CopperPilot/CopperPilotDronePCB/review/renders/lioncircuits_dfm/pcb_u9_fpaste_comparison.png

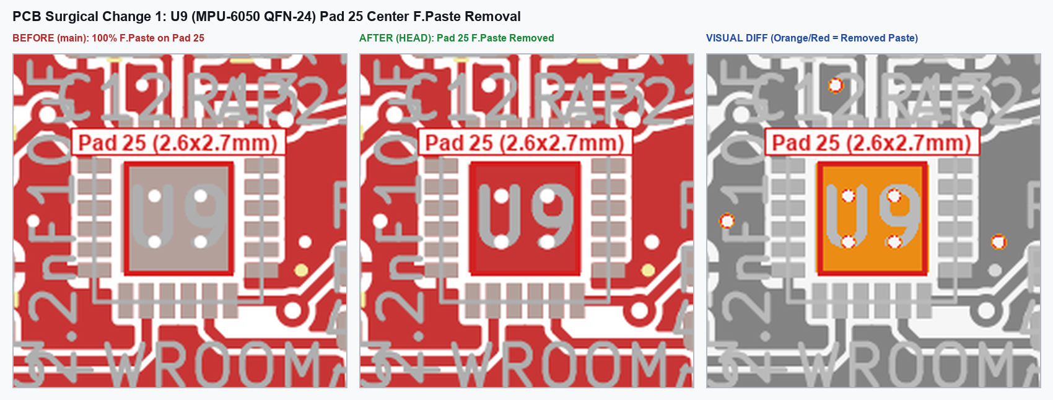
review/renders/lioncircuits_dfm/pcb_u9_fpaste_comparison.png
