CopperPilot/CopperPilotDronePCB/review/final/drc_report.txt

** Drc report for CopperPilotDrone.kicad_pcb **
** Created on 2026-10-17T00:27:32 **
** Report includes: Errors, Warnings, Exclusions **

** Found 0 DRC violations **

** Found 0 unconnected pads **

** Found 60 Footprint errors **
[footprint_symbol_field_mismatch]: Missing symbol field 'MPN' in footprint
    Local override; warning
    @(135.9040 mm, 78.5520 mm): Footprint C1
[footprint_symbol_field_mismatch]: Missing symbol field 'MPN' in footprint
    Local override; warning
    @(142.6654 mm, 79.5642 mm): Footprint C3
[footprint_symbol_field_mismatch]: Missing symbol field 'MPN' in footprint
    Local override; warning
    @(142.4597 mm, 77.8002 mm): Footprint C4
[footprint_symbol_field_mismatch]: Missing symbol field 'MPN' in footprint
    Local override; warning
    @(145.5369 mm, 76.6331 mm): Footprint C5
[footprint_symbol_field_mismatch]: Missing symbol field 'MPN' in footprint
    Local override; warning
    @(125.9091 mm, 75.4278 mm): Footprint C6
[footprint_symbol_field_mismatch]: Missing symbol field 'MPN' in footprint
    Local override; warning
    @(124.3762 mm, 75.4355 mm): Footprint C7
[footprint_symbol_field_mismatch]: Missing symbol field 'MPN' in footprint
    Local override; warning
    @(144.8905 mm, 107.3125 mm): Footprint C9
[footprint_symbol_field_mismatch]: Missing symbol field 'MPN' in footprint
    Local override; warning
    @(142.5616 mm, 107.7798 mm): Footprint C10
[footprint_symbol_field_mismatch]: Missing symbol field 'MPN' in footprint
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
    Local override; warning
    @(121.1491 mm, 66.1481 mm): Footprint SW1
[footprint_symbol_field_mismatch]: Missing symbol field 'MPN' in footprint
    Local override; warning
    @(114.0000 mm, 82.7000 mm): Footprint SW2
[footprint_symbol_field_mismatch]: Missing symbol field 'MPN' in footprint
    Local override; warning
    @(114.0000 mm, 88.5000 mm): Footprint SW3
[footprint_symbol_field_mismatch]: Missing symbol field 'MPN' in footprint
    Local override; warning
    @(145.2245 mm, 73.8607 mm): Footprint U2

** Ignored checks **
    - Footprint has no courtyard defined
    - Track endpoint not centered on via
    - Tuning profile track geometries
    - Footprint doesn't match symbol's footprint filters
    - Footprint component type doesn't match footprint pads
    - Footprint doesn't match copy in library

** End of Report **
