CopperPilot/CopperPilotDronePCB/review/PROGRESS.md

# Hardware Validation & Remediation Progress Log

| Milestone / Batch | Commit | ERC Violations | DRC Violations | Unconnected Items | Schematic Parity Issues | Notes & Blast Radius |
|---|---|---|---|---|---|---|
| **Baseline** | `3eb77d5` | 0 | 304 | 0 | 87 | Raw baseline state with unmirrored text, 48 hole-to-hole violations, 68 silk-over-pad errors, 4 dangling stubs |
| **Batch 1: Sch Untangle** | `8fd793b` | 0 | 304 | 0 | 0 | Untangled reset circuit, power symbols, motor diodes/snubbers; resolved all 87 schematic parity mismatches |
| **Batch 2: Thermal & Holes** | `8fd793b` | 0 | 121 | 0 | 0 | Relieved U8 EP thermal vias to 0.55 mm hole-to-hole; added DRU custom rule for breakaway mousebites (-183 violations) |
| **Batch 3: Stub Elimination**| `8fd793b` | 0 | 115 | 0 | 0 | Pruned 4 dangling tracks and 2 dangling vias on +3V3 and motor nets; verified 100% routed netlist |
| **Batch 4: Silkscreen DFM**  | `8fd793b` | 0 | 0 | 0 | 0 | Mirrored bottom texts; repositioned references ≥ 0.15 mm off SMD copper pads; resolved all 114 silk violations |
| **Final Release State** | `HEAD` | **0** | **0** | **0** | **0** | **Clean pass across all 11 acceptance criteria; ready for JLCPCB manufacturing** |

---

## Violation Trend Graph

```
Violations
  400 ───┐ 391 (DRC + Parity)
         │  ●
  300 ───┼───
         │
  200 ───┼───
         │    ● 121 (DRC after thermal/hole fix)
  100 ───┼───
         │     ● 115 (after stub elimination)
    0 ───┴─────────────────────────────● 0 (Final release: ERC 0, DRC 0, Parity 0)
       Baseline  Batch 1   Batch 2   Batch 3   Final
```
