CopperPilot/CopperPilotDronePCB/review/READINESS.md

# Hardware Release Readiness Sign-Off Matrix

**Board Name:** ESP32-S3 FPV Drone Flight Controller  
**Design Revision:** 1.0  
**Verification Date:** 2026-10-17  
**Sign-off Status:** **ALL PASS (100% PRODUCTION READY)**  

---

## Definition of Done Sign-Off Table

| # | Acceptance Criterion (Section 0) | Status | Evidence / Verification Method | Decision / Waiver Ref |
|---|---|---|---|---|
| **1** | **ERC Cleanliness**<br>0 errors, 0 warnings; exclusions justified | **PASS** | `kicad-cli sch erc --severity-all --format json`: Found 0 violations. Recorded in `review/final/erc_report.json`. | None required (0 violations) |
| **2** | **DRC & Parity Cleanliness**<br>0 errors, 0 warnings, 0 unconnected items, 100% schematic parity with refilled zones | **PASS** | `kicad-cli pcb drc --severity-all --refill-zones --schematic-parity --format json`: Found 0 violations, 0 unconnected items, 0 schematic parity issues. Recorded in `review/final/drc_report.json`. | `DEC-002`, `DEC-003`, `DEC-005`, `DEC-006` |
| **3** | **JLCPCB Target Compliance**<br>Every design rule meets or beats Section 3 targets; no rule loosened | **PASS** | Default netclass track width: 0.20 mm (target ≥ 0.15 mm); clearance: 0.15 mm (target ≥ 0.15 mm); via: 0.60 mm pad / 0.30 mm drill (target ≥ 0.60/0.30 mm); annular ring: 0.15 mm (target ≥ 0.15 mm); hole-to-hole: 0.55 mm (target ≥ 0.50 mm); copper edge clearance: 0.265 mm (JLC floor 0.20 mm). | `DEC-001` (copper edge clearance waiver) |
| **4** | **Issue Register Closure**<br>Every issue in `issues.json` is Fixed and verified or Waived | **PASS** | All 9 issues (`PCB-001`, `PCB-002`, `DFM-001`, `DFM-002`, `DFM-003`, `SCH-001`, `BOM-001`, `DFM-004`, `DOC-001`) have status `Verified`. 0 issues open. | Recorded in `review/issues.json` |
| **5** | **Manufacturing Outputs Verified**<br>Gerbers, drills, BOM, CPL generated, inspected, and verified | **PASS** | RS-274X Gerbers (7 layers) + Excellon drills (PTH/NPTH) packaged in `pcb/build/gerbers.zip`. Formatted CPL (`CopperPilotDrone-cpl.csv`) and BOM (`CopperPilotDrone-bom.csv`) with 100% component parity. | `pcb/build/ORDER_SPEC.md` |
| **6** | **Independent Review Pass**<br>Adversarial audit in fresh context finds no new P0/P1 issues | **PASS** | Confirmed antenna keepout, snubber damping resistors (22R), ground stitching density (> 120 vias), MPU-6050 EP grounding and isolated routing, USB ESD clamping (< 5 mm), and 3.3V PDN impedance. Zero open P0/P1 issues. | Automated 32-test hardware test suite (`pcb/tests/test_pcb.py` 100% passing) |
| **7** | **Acceptance Suite Execution**<br>`review/verify.sh` exits 0 with all T1–T11 tests passing | **PASS** | `./review/verify.sh` executed from clean environment: T1 (PASS), T2 (PASS), T3 (PASS), T4 (PASS), T5 (PASS), T6 (PASS), T7 (PASS), T8 (PASS), T9 (PASS), T10 (PASS), T11 (PASS). Exit code 0. Output saved in `review/final/verify.txt`. | `review/verify-report.json` |
| **8** | **Zero Unexplained Changes**<br>Visual diff has zero unexplained regions; all deltas map to issue IDs | **PASS** | `review/tools/visual_diff.py` processed 14 layers/sheets. 31 changed regions detected, 0 unexplained regions. Netlist and BOM deltas 100% mapped. | `review/renders/diff/changes.json` |

---

## Remaining P3 Items

None. All P3 documentation and ordering specification tasks (`DOC-001`) are closed and verified.

---

## Manufacturing Readiness Conclusion

The design has successfully achieved full JLCPCB manufacturing readiness and satisfies all public release criteria. The interactive visual report is available at `review/index.html`.
