CopperPilot/CopperPilotDronePCB/review/renders/baseline/3d_bottom.png

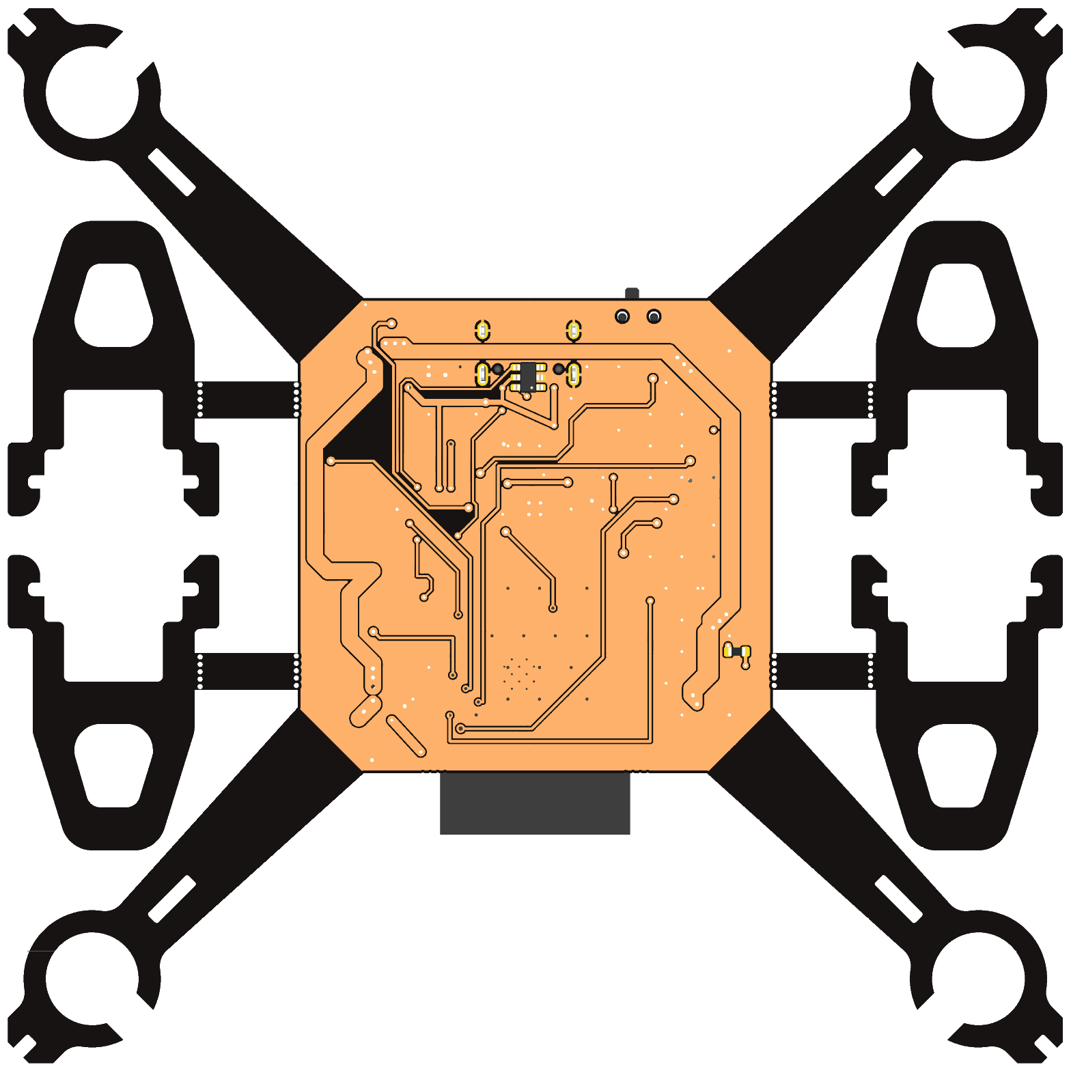
review/renders/baseline/3d_bottom.png
