CopperPilot/CopperPilotDronePCB/review/renders/baseline/3d_isometric.png

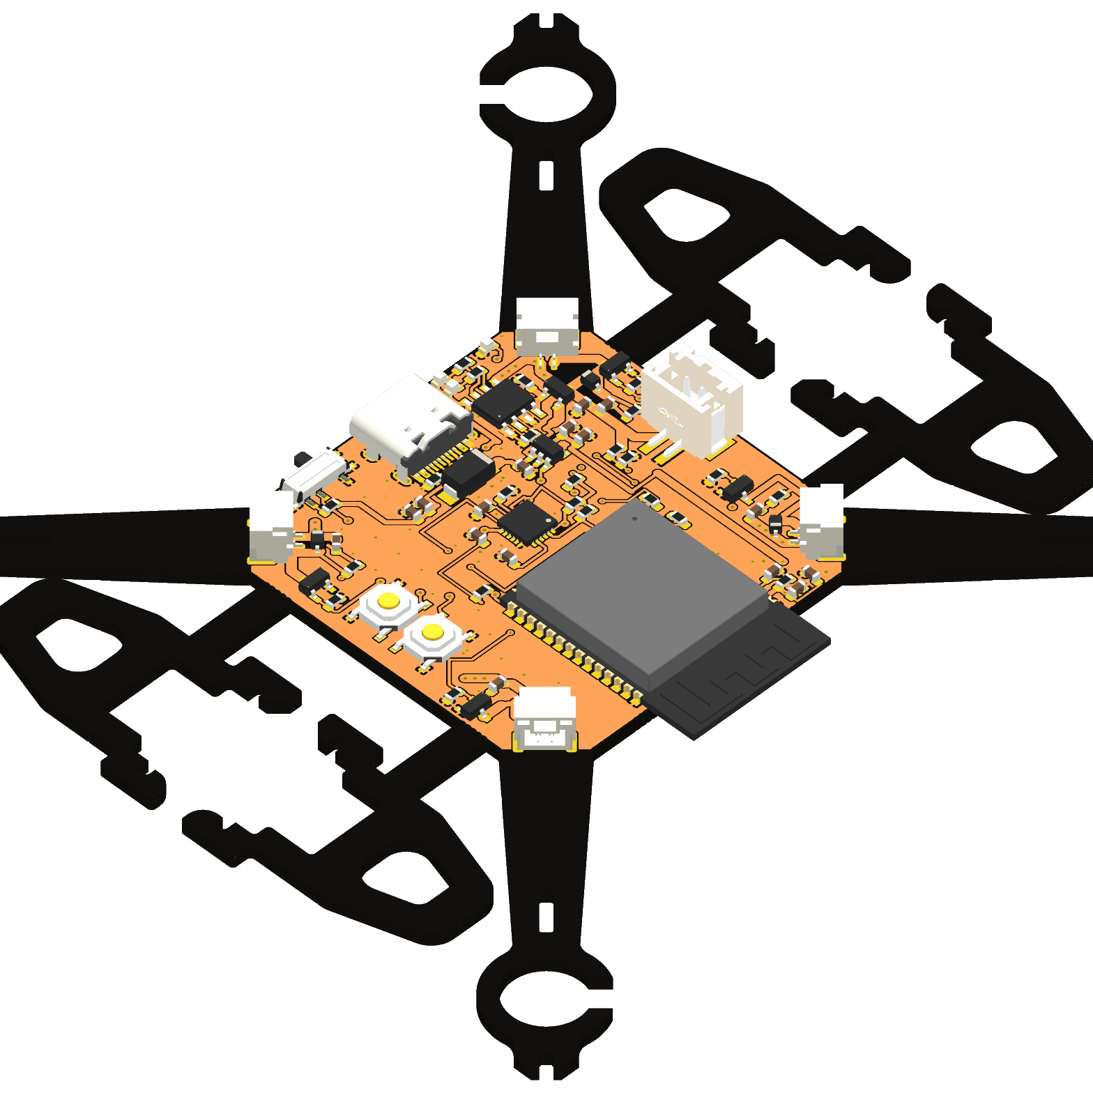
review/renders/baseline/3d_isometric.png
