CopperPilot/CopperPilotDronePCB/review/renders/baseline/B.Cu.png

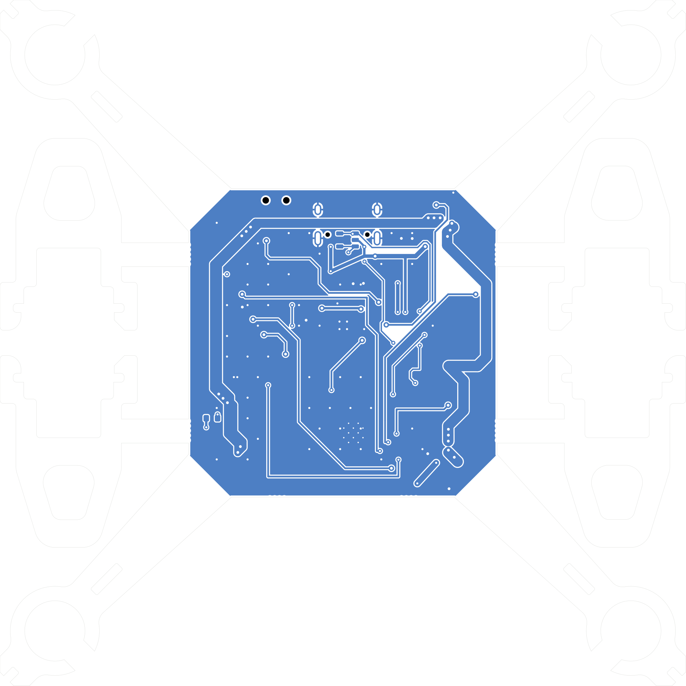
review/renders/baseline/B.Cu.png
