CopperPilot/CopperPilotDronePCB/review/renders/baseline/F.Paste.png

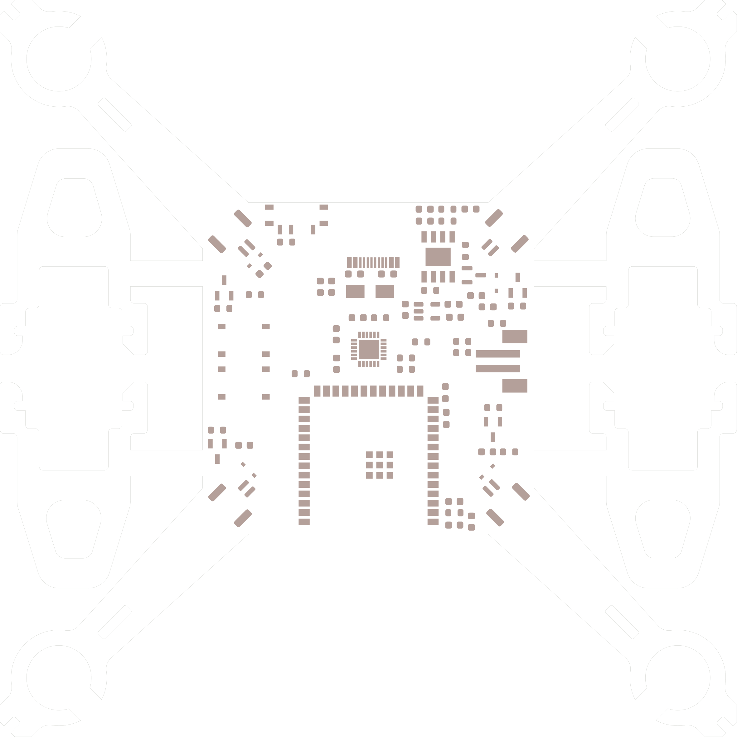
review/renders/baseline/F.Paste.png
