CopperPilot/CopperPilotDronePCB/review/renders/baseline/F.SilkS.png

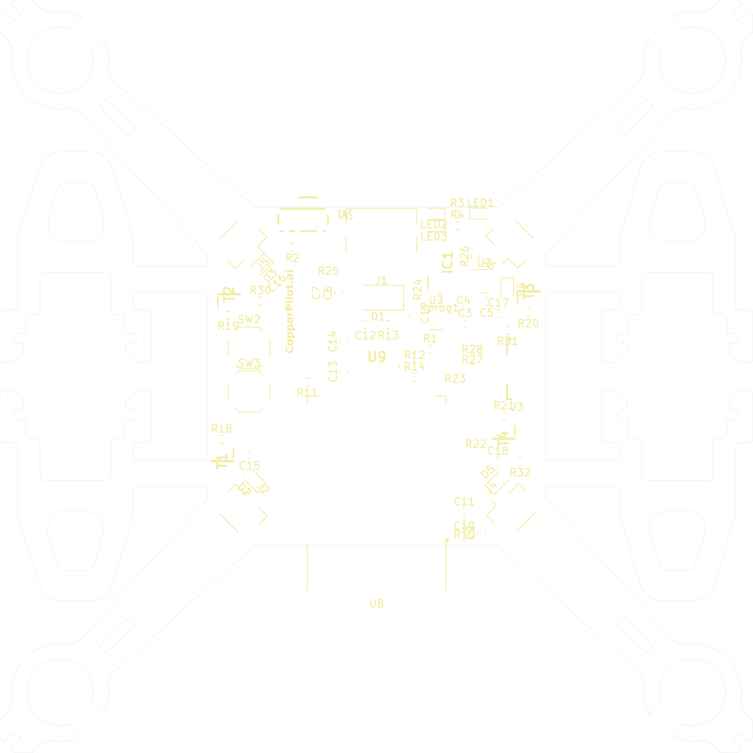
review/renders/baseline/F.SilkS.png
