CopperPilot/CopperPilotDronePCB/review/renders/diff/B.Fab.png

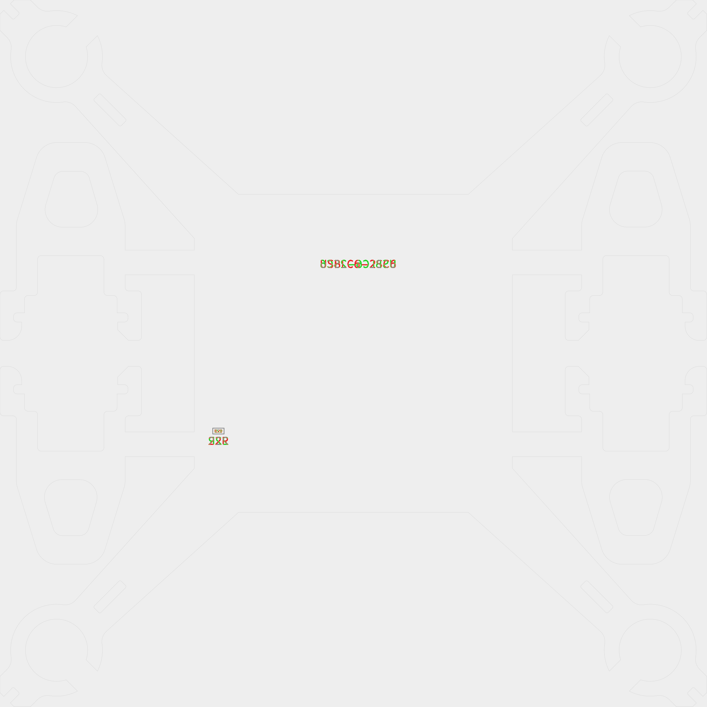
review/renders/diff/B.Fab.png
