CopperPilot/CopperPilotDronePCB/review/renders/diff/B.Mask.png

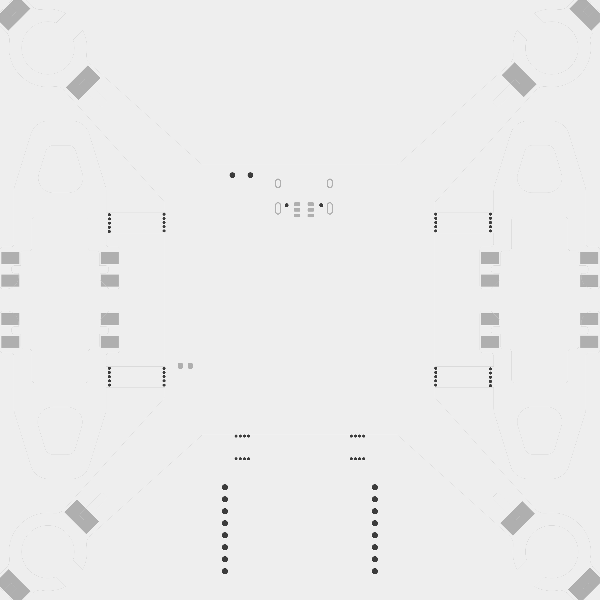
review/renders/diff/B.Mask.png
