CopperPilot/CopperPilotDronePCB/review/renders/diff/F.Cu.png

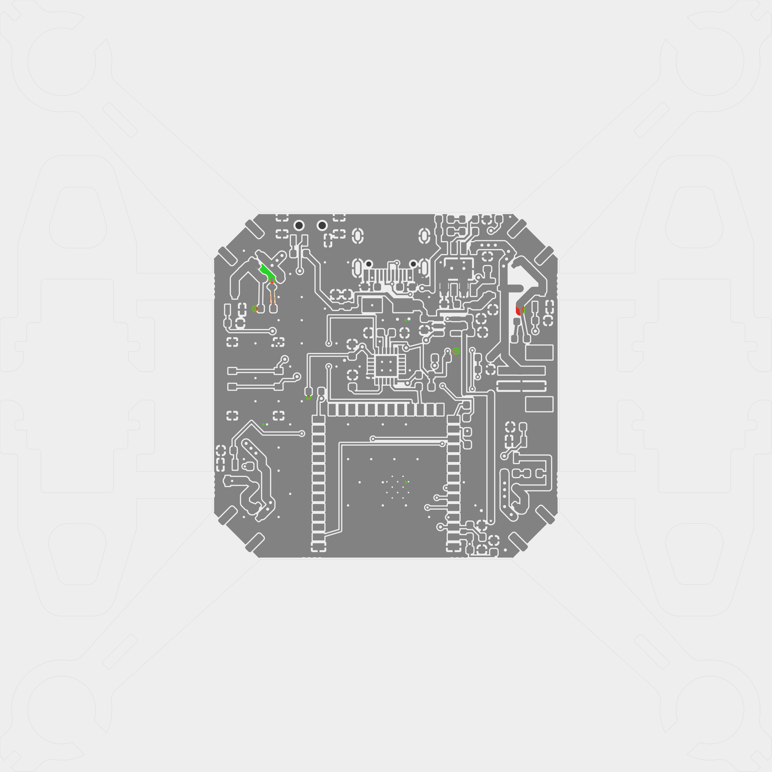
review/renders/diff/F.Cu.png
