CopperPilot/CopperPilotDronePCB/review/renders/diff/F.Fab.png

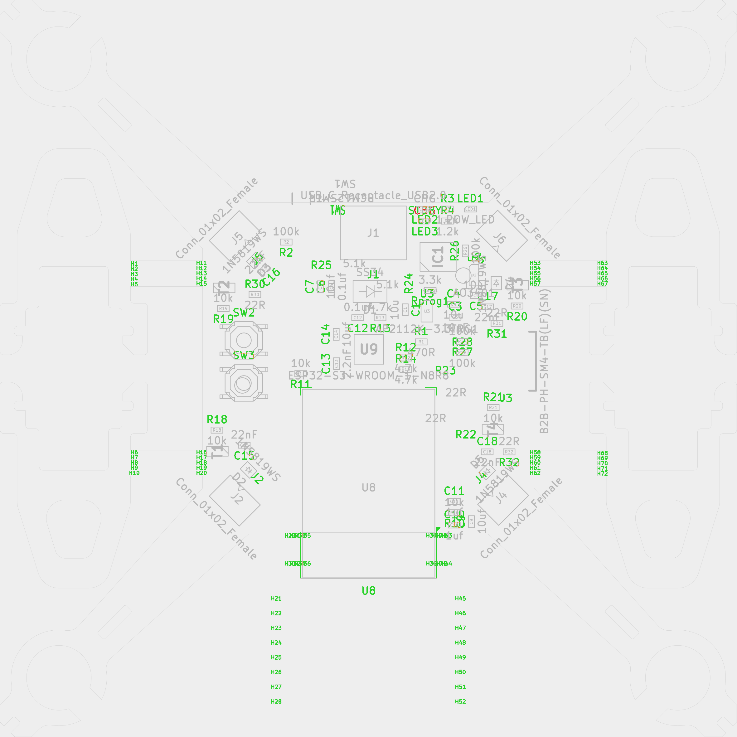
review/renders/diff/F.Fab.png
