CopperPilot/CopperPilotDronePCB/review/renders/final/3d_top.png

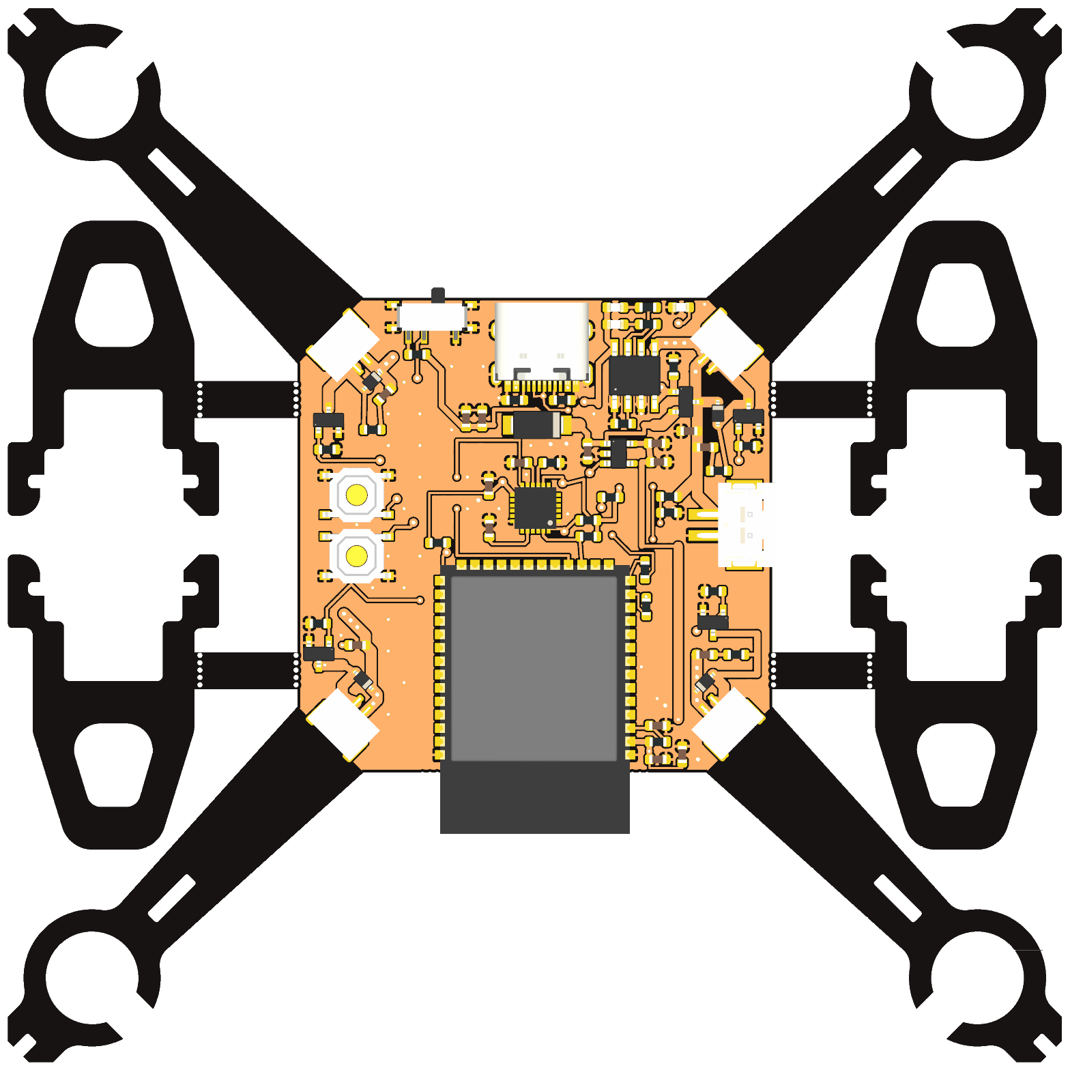
review/renders/final/3d_top.png
