CopperPilot/CopperPilotDronePCB/review/renders/final/F.Mask.png

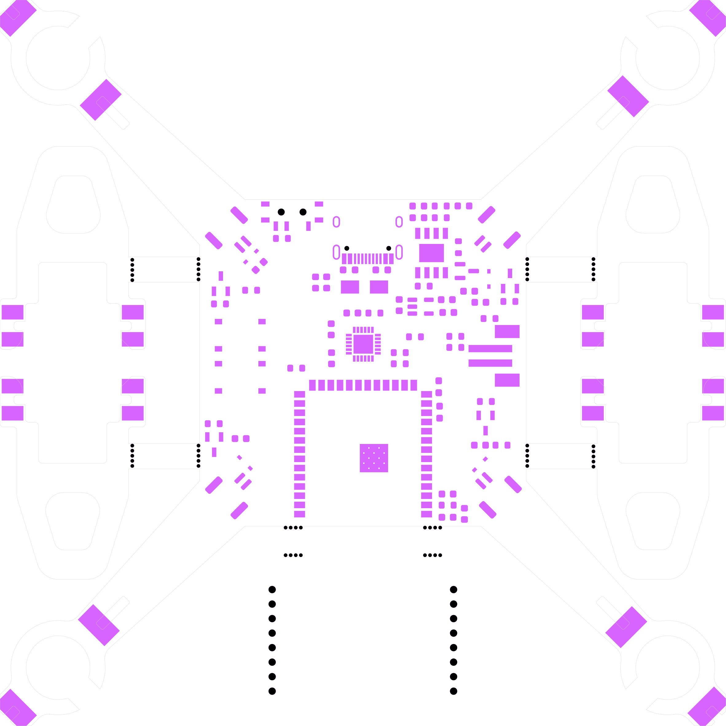
review/renders/final/F.Mask.png
