CopperPilot/CopperPilotDronePCB/review/renders/final/F.SilkS.png

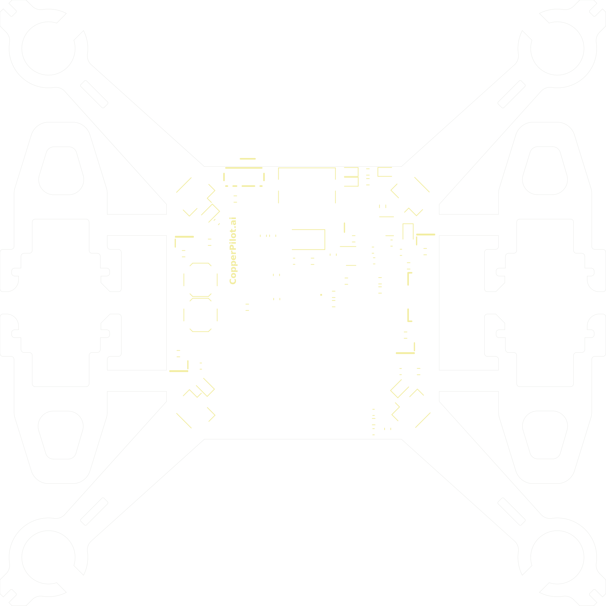
review/renders/final/F.SilkS.png
