CopperPilot/CopperPilotDronePCB/review/renders/final/schematic.png

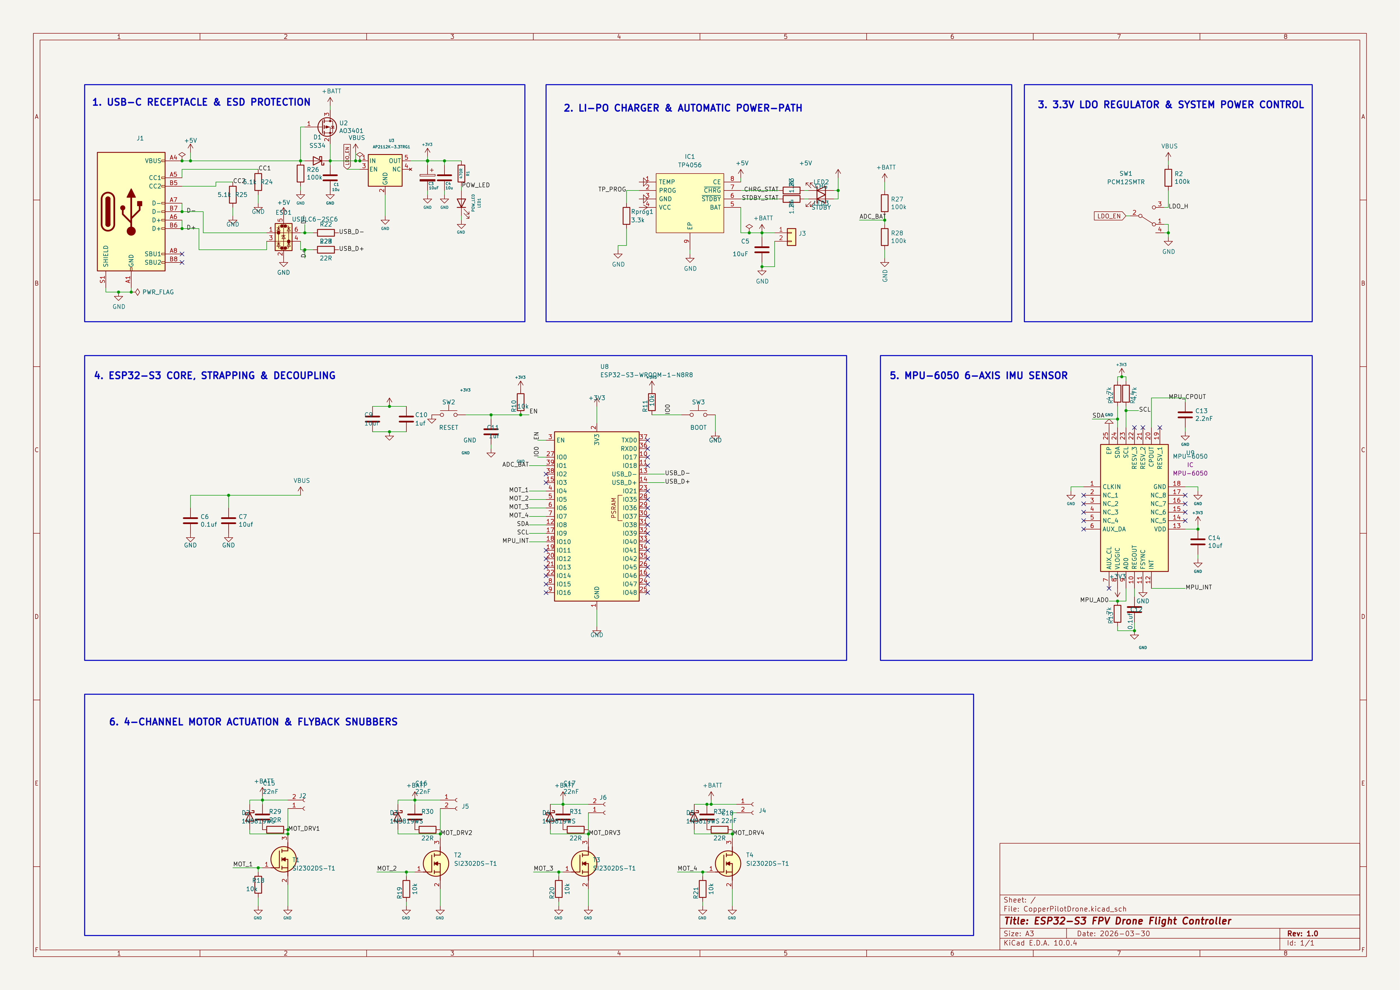
review/renders/final/schematic.png
