CopperPilot/CopperPilotDronePCB/review/renders/lioncircuits_dfm/pcb_via_upsize_bcu_comparison.png

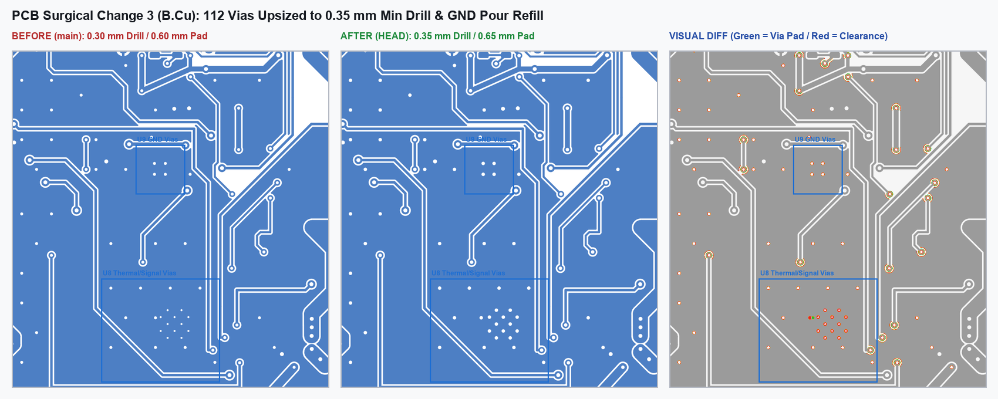
review/renders/lioncircuits_dfm/pcb_via_upsize_bcu_comparison.png
