CopperPilot/CopperPilotDronePCB/review/renders/issues/DFM-001/after.png

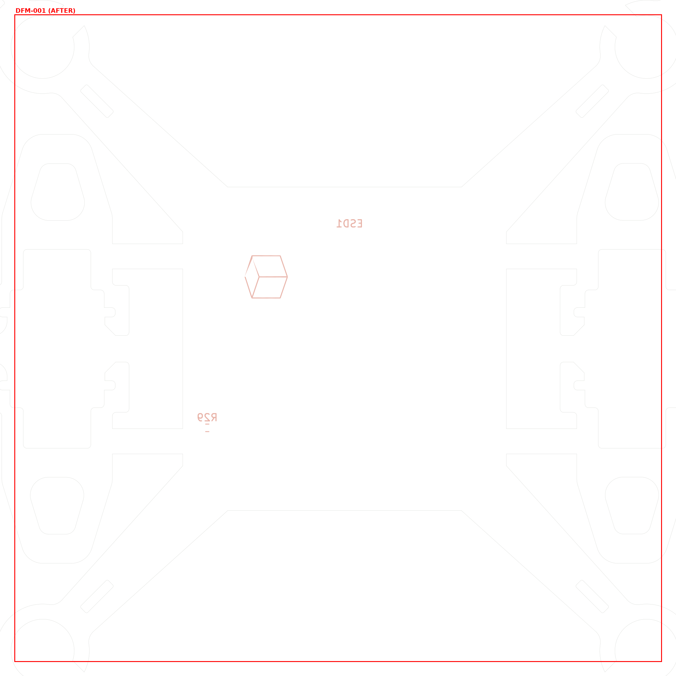
review/renders/issues/DFM-001/after.png
