CopperPilot/CopperPilotDronePCB/review/renders/issues/DFM-002/before.png

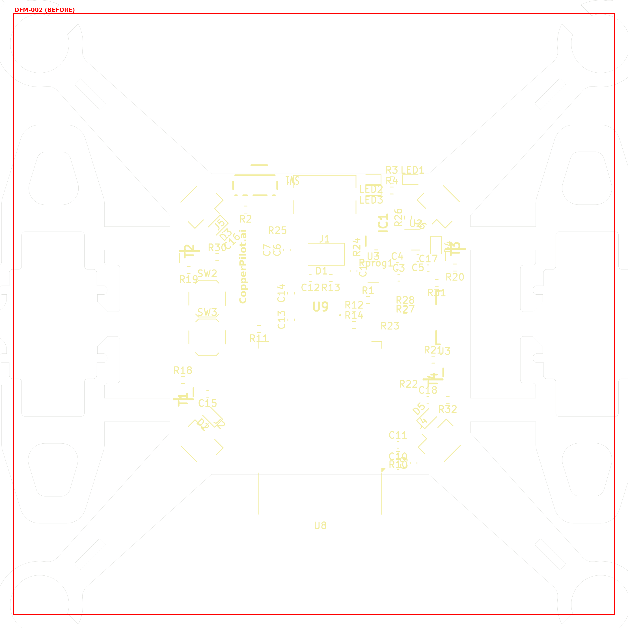
review/renders/issues/DFM-002/before.png
