CopperPilot/CopperPilotDronePCB/review/renders/issues/DFM-002/diff.png

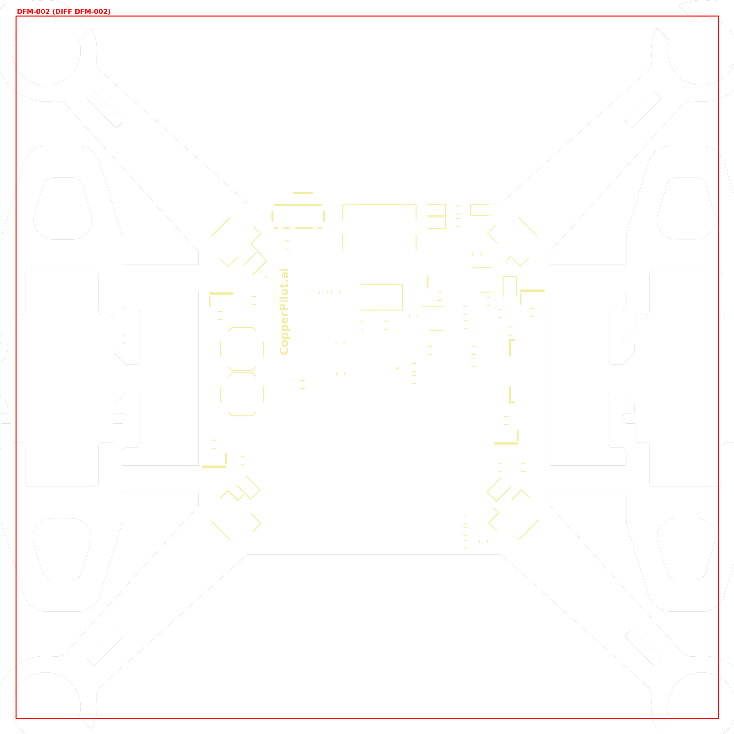
review/renders/issues/DFM-002/diff.png
