CopperPilot/CopperPilotDronePCB/review/renders/issues/DOC-001/after.png

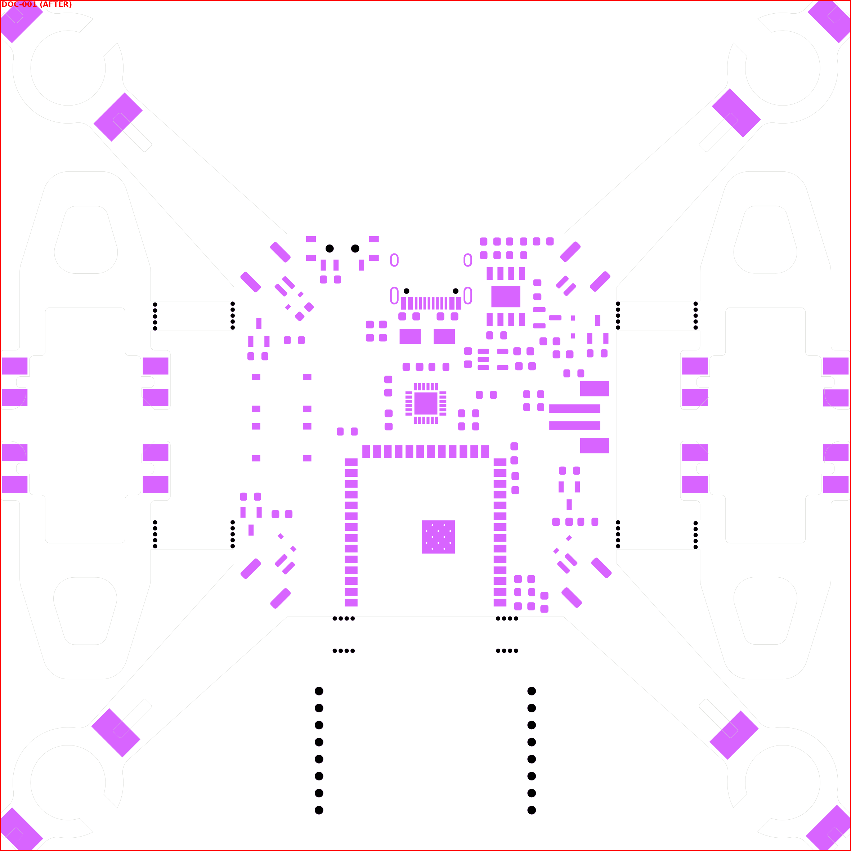
review/renders/issues/DOC-001/after.png
