CopperPilot/CopperPilotDronePCB/review/renders/issues/PCB-001/before.png

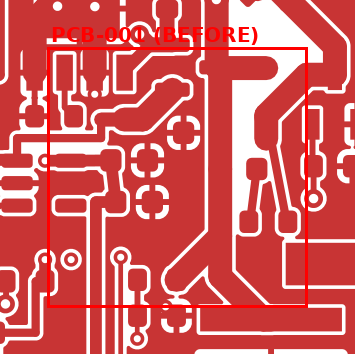
review/renders/issues/PCB-001/before.png
