CopperPilot/CopperPilotDronePCB/review/renders/issues/PCB-002/after.png

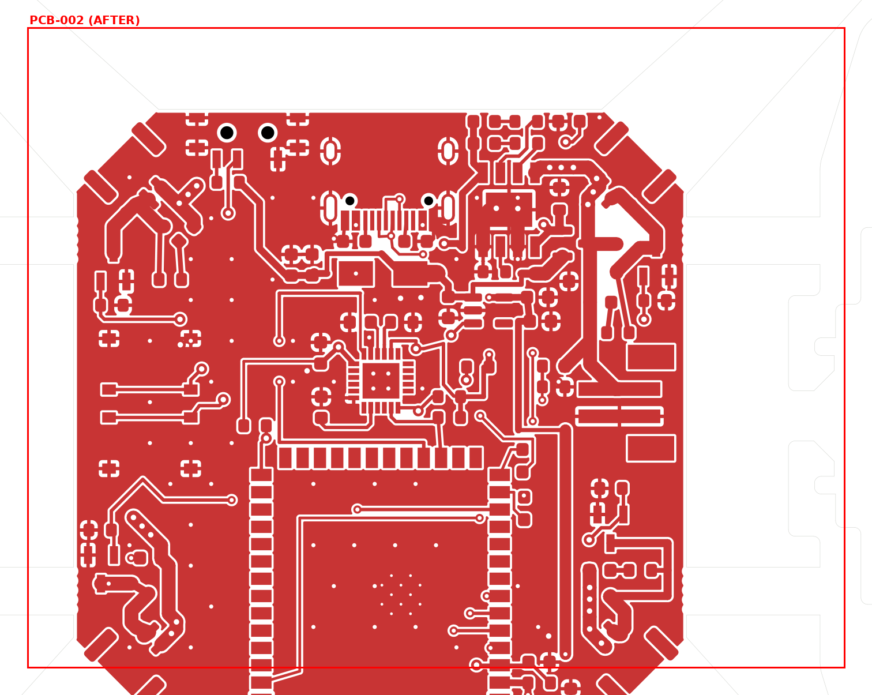
review/renders/issues/PCB-002/after.png
