CopperPilot/CopperPilotDronePCB/review/renders/issues/SCH-001/after.png

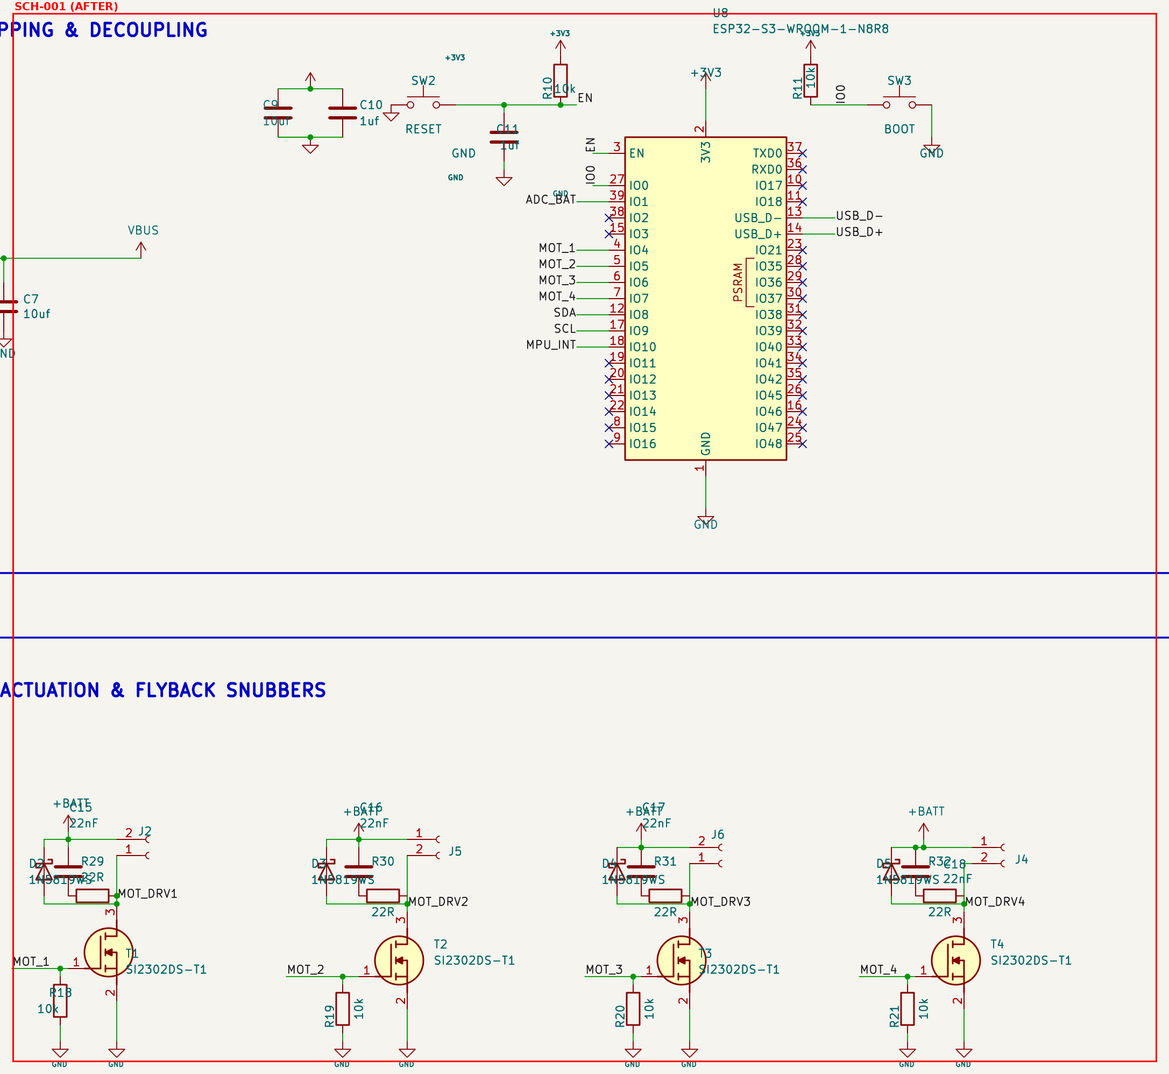
review/renders/issues/SCH-001/after.png
