CopperPilot/CopperPilotDronePCB/review/renders/baseline/schematic.pdf

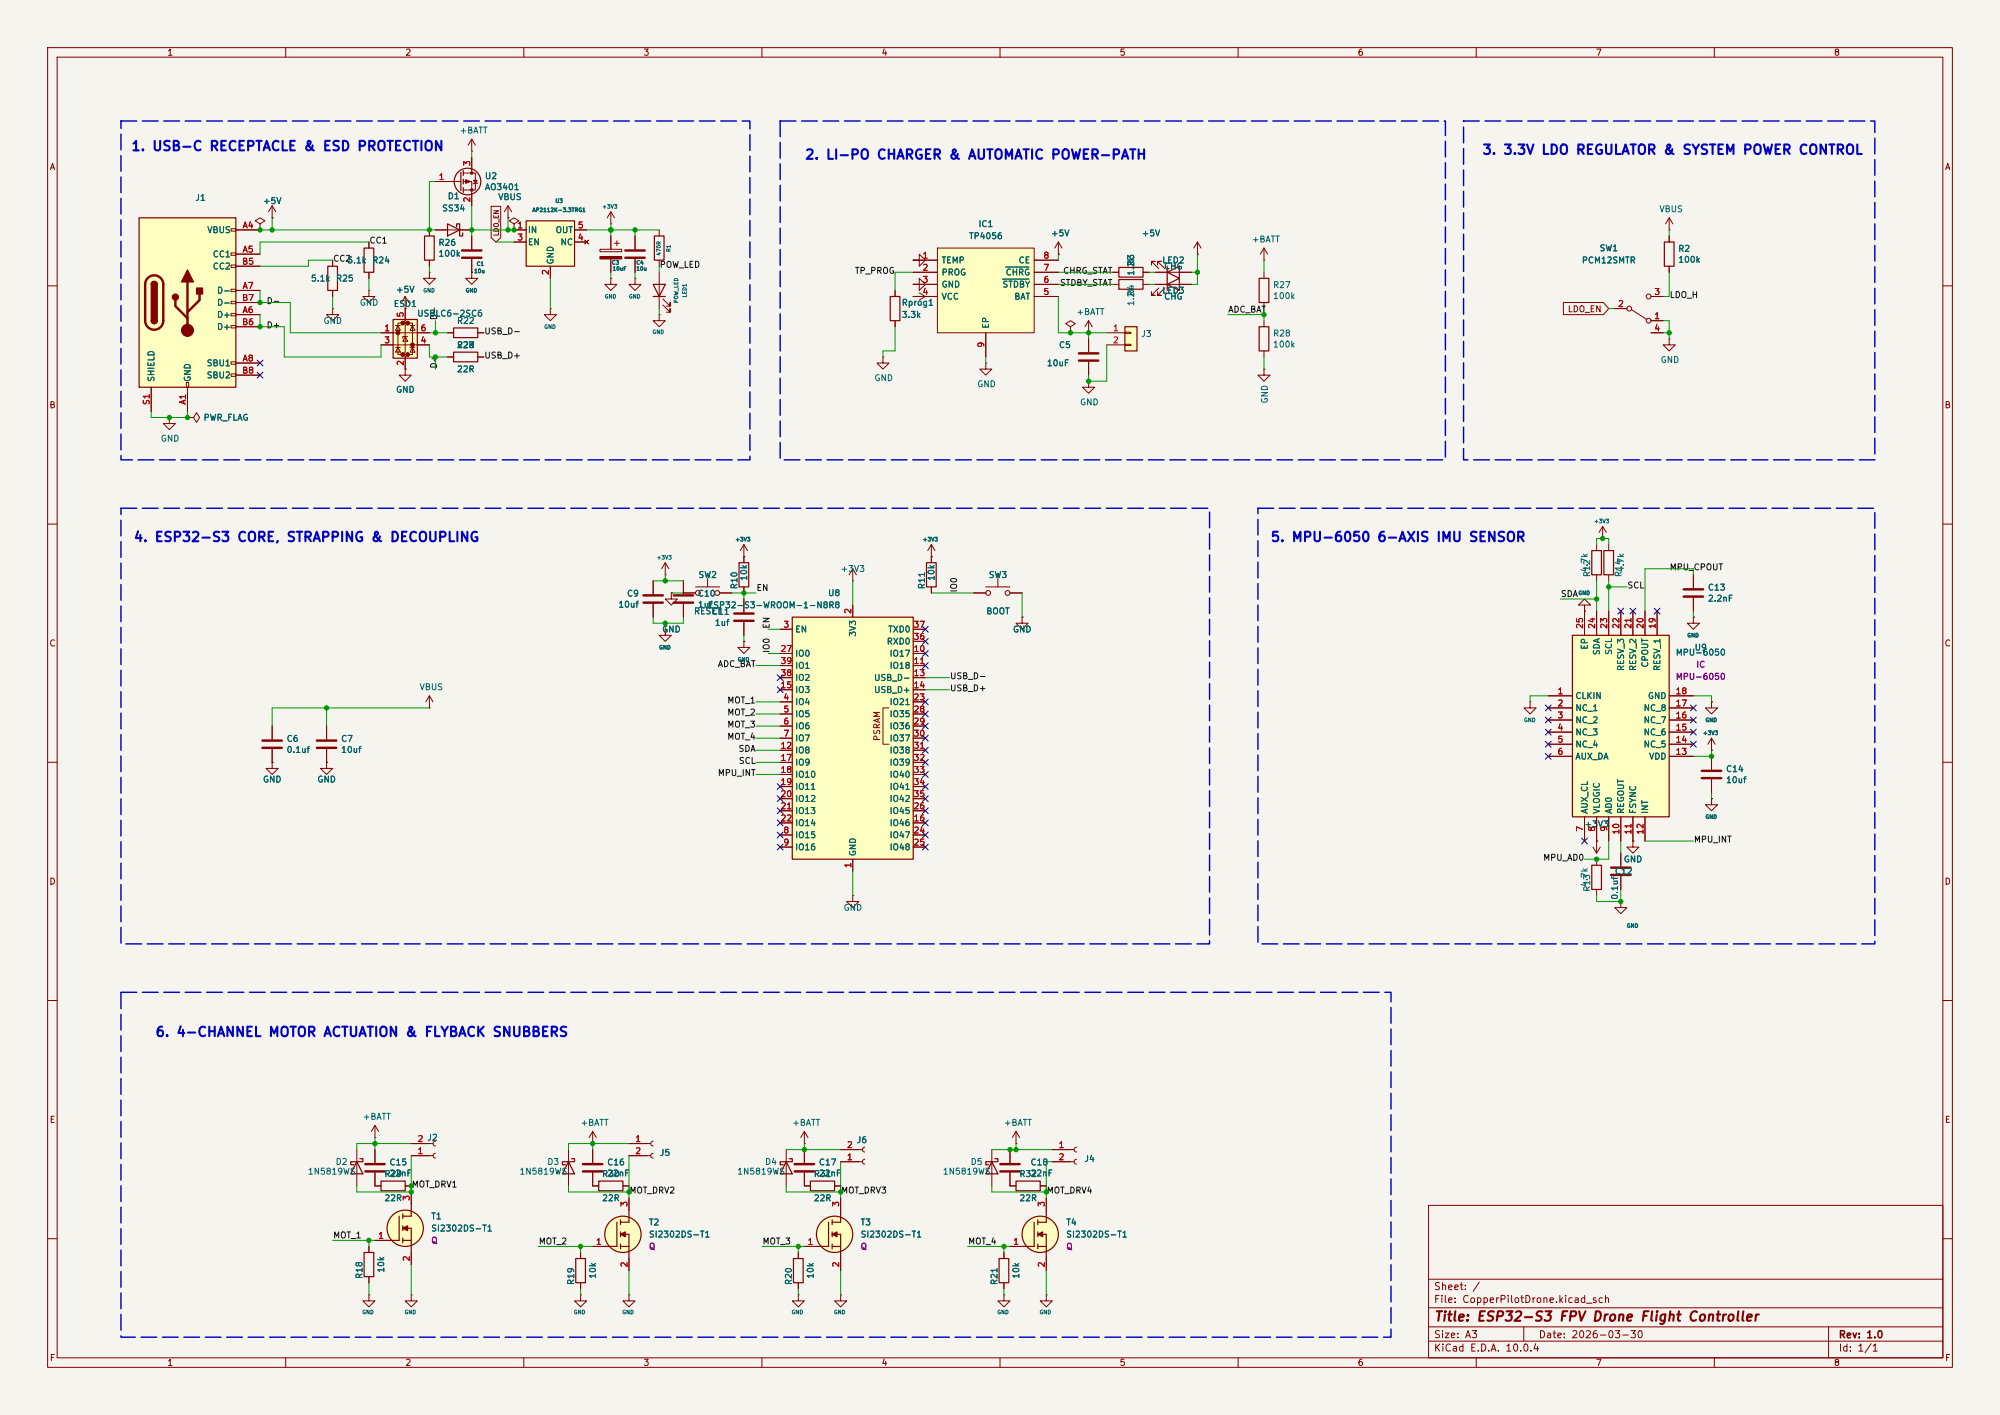
[picture p23: page 1]

9 REGOUT 10 FSYNC 11 INT 12 VDD 13 NC_5 14 NC_6 15 NC_7 16 NC_8 17 GND 18 RESV_1 19 CPOUT 20 RESV_2 21 RESV_3 22 SCL 23 SDA 24 EP 25 U9 MPU-6050

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

6. 4-CHANNEL MOTOR ACTUATION & FLYBACK SNUBBERS

Sheet: /
File: CopperPilotDrone.kicad_sch
Title: ESP32-S3 FPV Drone Flight Controller

Size: A3 | Rev: 1.0 | F Date: 2026-03-30
KiCad E.D.A. 10.0.4 | Id: 1/1
