CopperPilot/CopperPilotDronePCB/review/renders/final/schematic.pdf

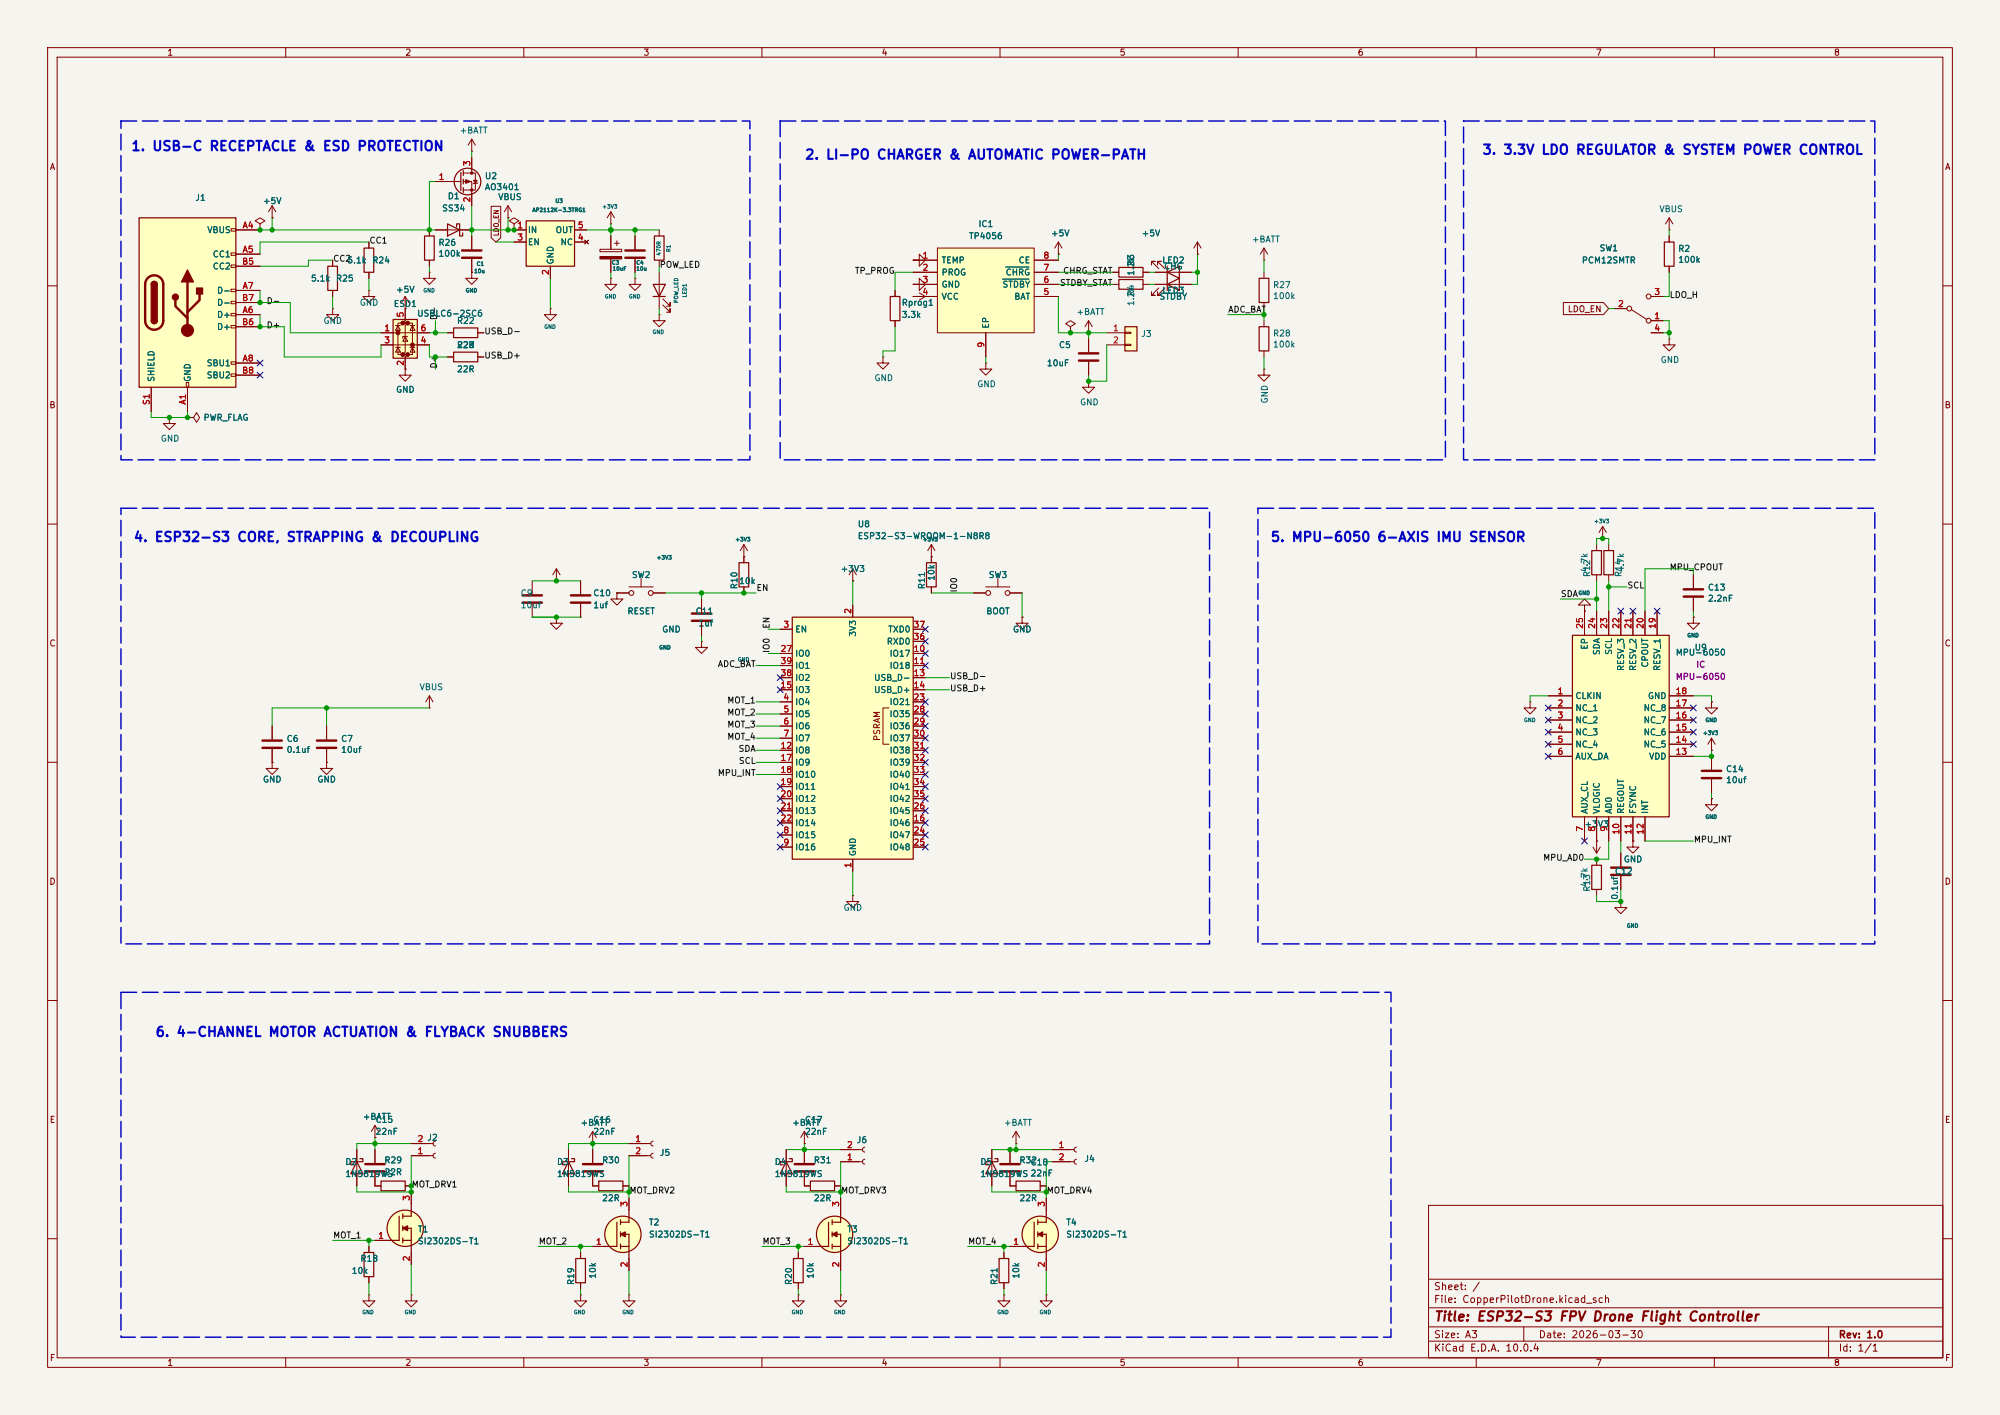
[picture p24: page 1]

2. LI-PO CHARGER & AUTOMATIC POWER-PATH 1. USB-C RECEPTACLE & ESD PROTECTION

9 REGOUT 10 FSYNC 11 INT 12 VDD 13 NC_5 14 NC_6 15 NC_7 16 NC_8 17 GND 18 RESV_1 19 CPOUT 20 RESV_2 21 RESV_3 22 SCL 23 SDA 24 EP 25 C13
GND

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

6. 4-CHANNEL MOTOR ACTUATION & FLYBACK SNUBBERS

Sheet: /
File: CopperPilotDrone.kicad_sch
Title: ESP32-S3 FPV Drone Flight Controller

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
