CopperPilot/CopperPilotDronePCB/pcb/CopperPilotDrone.kicad_pcb

## KiCad design pcb/CopperPilotDrone.kicad_pcb (2026-10-28)

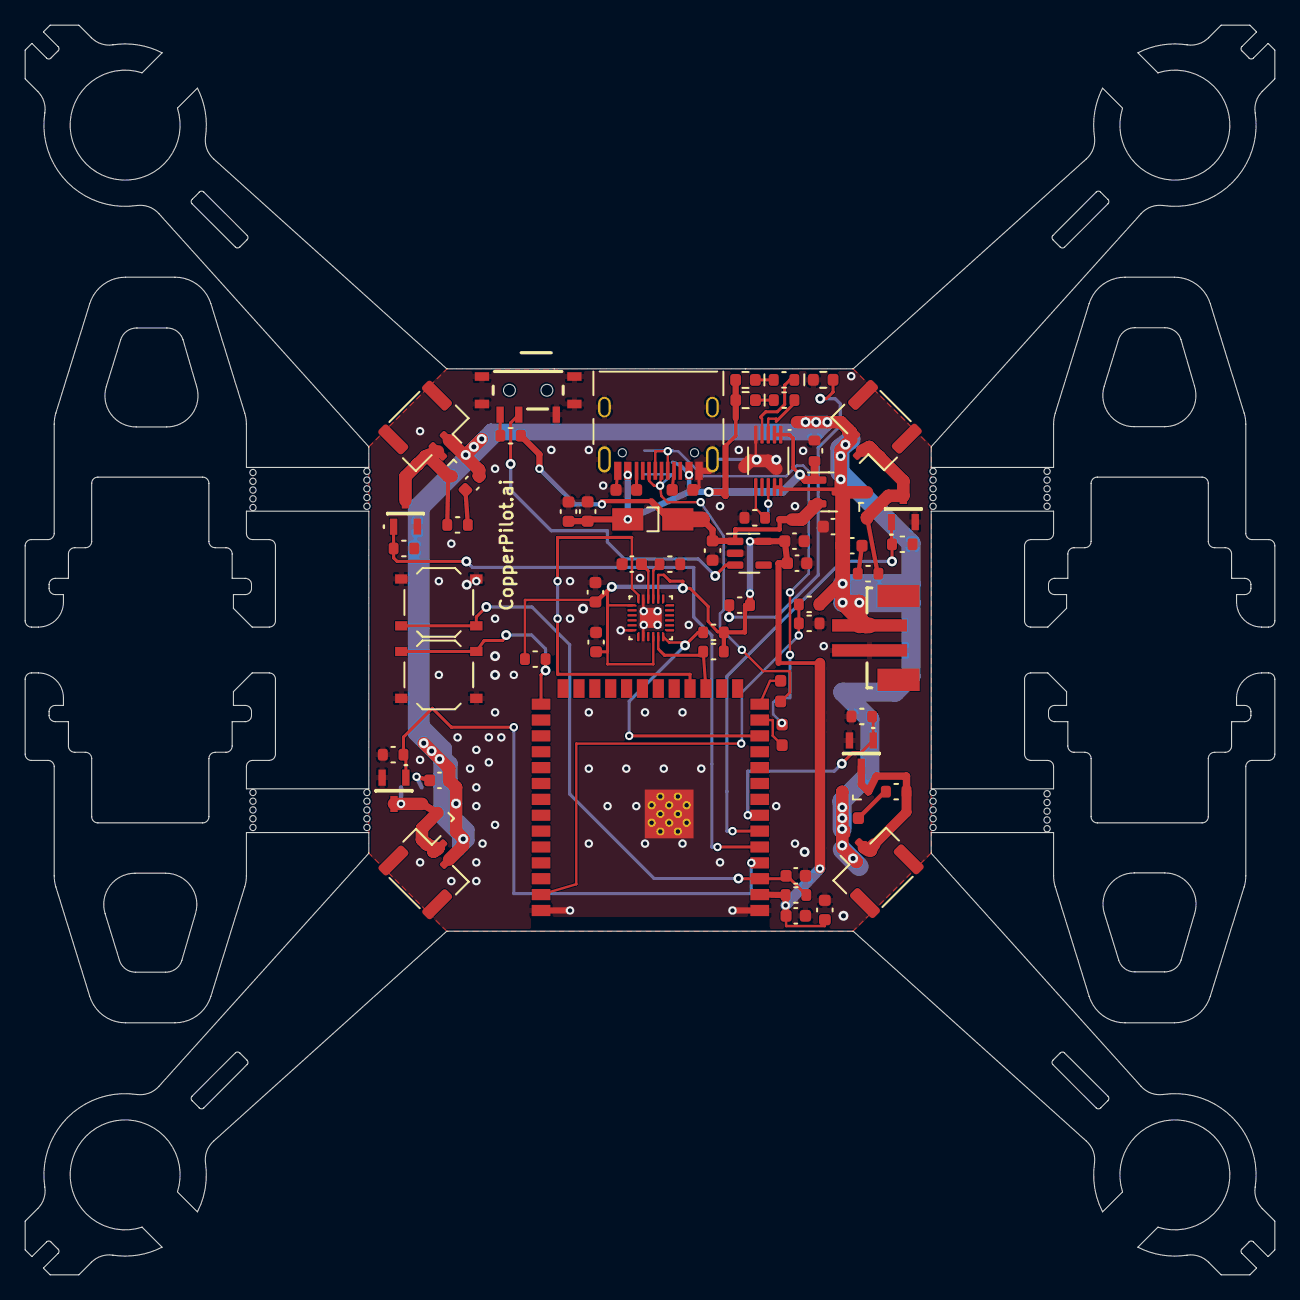
[picture p25: board CopperPilotDrone.kicad_pcb from above]

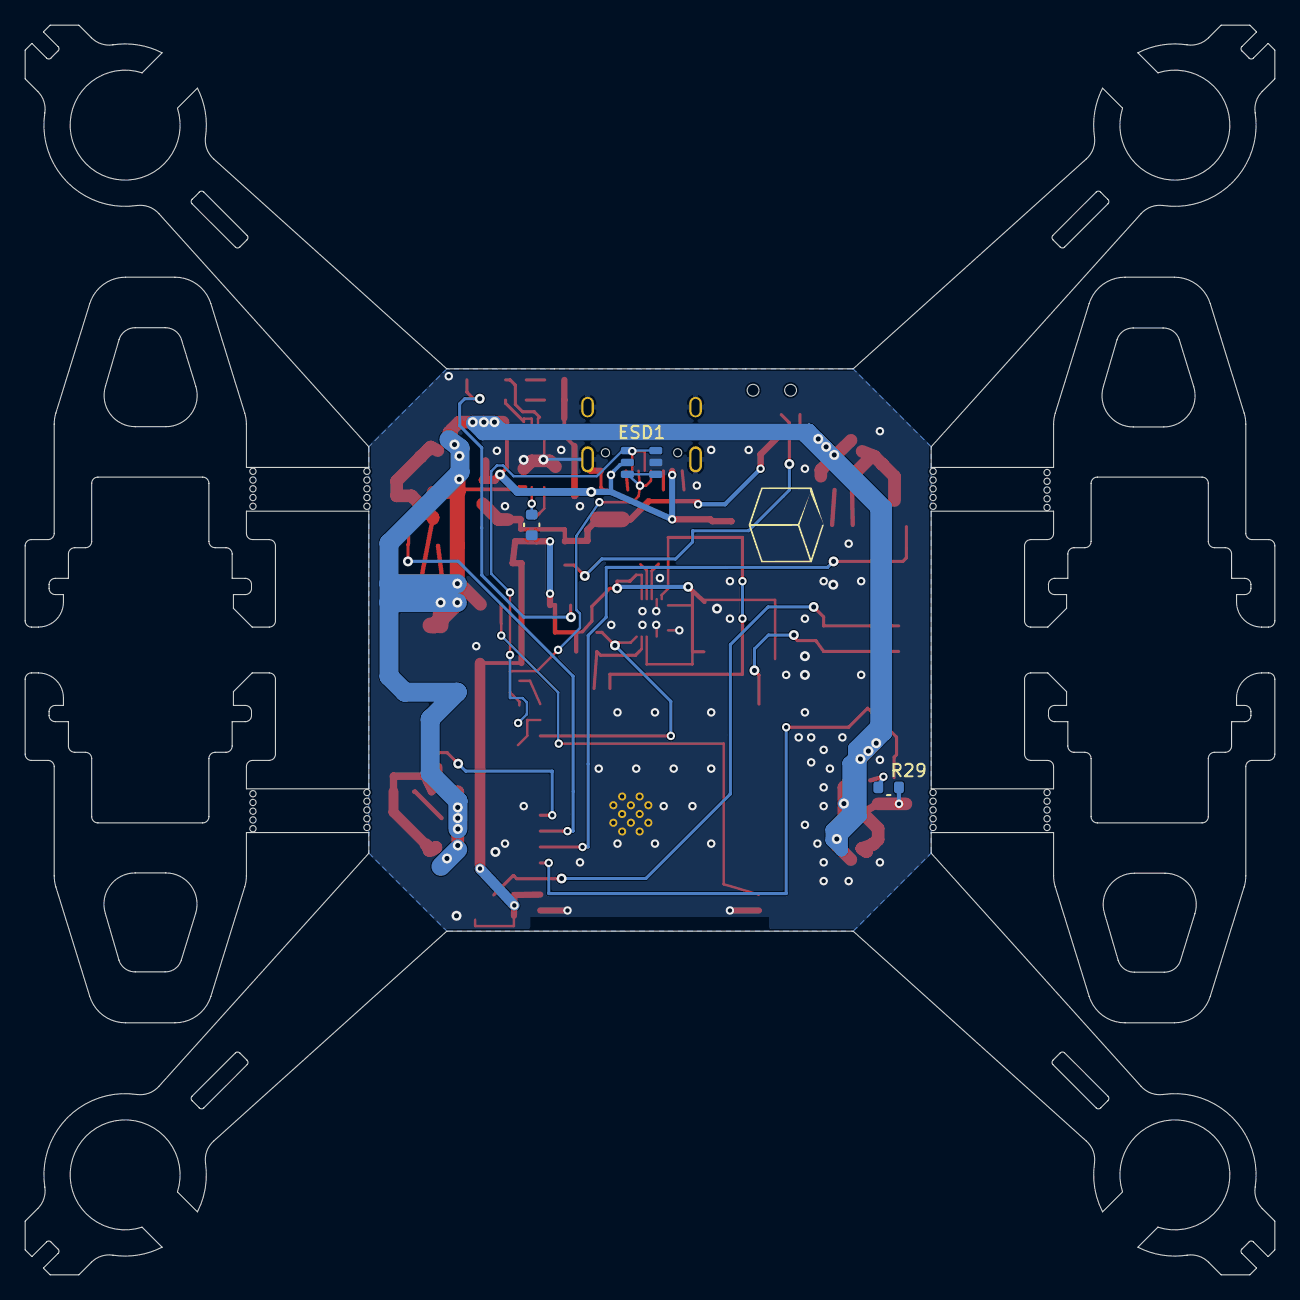
[picture p26: board CopperPilotDrone.kicad_pcb from below]

Board: 2 copper layers, 100.0 x 100.0 mm, 109 parts (3 on the bottom side), 40 nets.

Parts:
C1, C3, C4, C5, C7, C9, C14: 10uF; C_0603_1608Metric
C6, C12, C13: 0.1uf; C_0603_1608Metric
C10, C11: 1uf; C_0603_1608Metric
C15, C16, C17, C18: 22nF; C_0603_1608Metric
D1: SS34; D_SMA
D2, D3, D4, D5: 1N5819WS; D_SOD-323
ESD1: USBLC6-2SC6; SOT-23-6
H1, H2, H3, H4, H5, H6, H7, H8, H9, H10, H11, H12, H13, H14, H15, H16, H17, H18, H19, H20, H53, H54, H55, H56, H57, H58, H59, H60, H61, H62, H63, H64, H65, H66, H67, H68, H69, H70, H71, H72: NPTH; MountingHole_0.5mm
IC1: MCP73833T-AMI/UN; MSOP-10_3x3mm_P0.5mm
J1: USB_C_Receptacle_USB2.0; USB_C_Receptacle_HRO_TYPE-C-31-M-12
J2, J4, J5, J6: Conn_01x02_Female; JST_GH_SM02B-GHS-TB_1x02-1MP_P1.25mm_Horizontal
J3: B2B-PH-SM4-TB(LF)(SN); CONN-SMD_B2B-PH-SM4-TB-LF-SN
LED1: POW_LED; LED_0603_1608Metric
LED2: CHG; LED_0603_1608Metric
LED3: STDBY; LED_0603_1608Metric
R1: 470R; R_0603_1608Metric
R2, R26, R27, R28: 100k; R_0603_1608Metric
R3, R4: 1.2k; R_0603_1608Metric
R10, R11, R18, R19, R20, R21, R33: 10k; R_0603_1608Metric
R12, R13, R14: 4.7k; R_0603_1608Metric
R22, R23, R29, R30, R31, R32: 22R; R_0603_1608Metric
R24, R25: 5.1k; R_0603_1608Metric
Rprog1: 3.3k; R_0603_1608Metric
SW1: PCM12SMTR; slide switch spdt
SW2, SW3: TS-1187A; SW_Push_1P1T_XKB_TS-1187A
T1, T2, T3, T4: SI2302DS-T1; SOT95P237X112-3N
U2: AO3401; SOT-23
U3: AP2112K-3.3TRG1; SOT-23-5
U8: ESP32-S3-WROOM-1-N8R8; ESP32-S3-WROOM-1
U9: MPU-6500; QFN-24-1EP_3x3mm_P0.4mm_EP1.75x1.6mm

Connections:
+3V3: C3.1, C4.1, C9.1, C10.1, C13.1, C14.1, R1.2, R10.2, R11.2, R12.2, R14.2, U3.5 (OUT), U8.2 (3V3), U9.8, U9.13, U9.22
+5V: C6.1, C7.1, D1.2 (A), ESD1.5 (VBUS), IC1.1, IC1.2, J1.A4 (VBUS), J1.A9 (VBUS), J1.B4 (VBUS), J1.B9 (VBUS), LED2.2 (A), LED3.2 (A), R26.1, U2.1 (G)
+BATT: C5.1, C15.1, C16.1, C17.1, C18.1, D2.1 (K), D3.1 (K), D4.1 (K), D5.1 (K), IC1.9, IC1.10, J2.2, J3.1, J4.1, J5.1, J6.2, R27.1, U2.3 (D)
/ADC_BAT: R27.2, R28.1, U8.39 (IO1)
/CC1: J1.A5 (CC1), R24.1
/CC2: J1.B5 (CC2), R25.1
/CHRG_STAT: IC1.4, R3.2
/D+: ESD1.3 (I/O2), ESD1.4 (I/O2), J1.A6 (D+), J1.B6 (D+), R23.1
/D-: ESD1.1 (I/O1), ESD1.6 (I/O1), J1.A7 (D-), J1.B7 (D-), R22.1
/EN: C11.1, R10.1, SW2.2, U8.3 (EN)
/IO0: R11.1, SW3.1, U8.27 (IO0)
/LDO_H: R2.2, SW1.3 (C)
/MOT_1: R18.2, T1.1 (G), U8.4 (IO4)
/MOT_2: R19.2, T2.1 (G), U8.5 (IO5)
/MOT_3: R20.2, T3.1 (G), U8.6 (IO6)
/MOT_4: R21.2, T4.1 (G), U8.7 (IO7)
/MOT_DRV1: D2.2 (A), J2.1, R29.1, T1.3 (D)
/MOT_DRV2: D3.2 (A), J5.2, R30.1, T2.3 (D)
/MOT_DRV3: D4.2 (A), J6.1, R31.1, T3.3 (D)
/MOT_DRV4: D5.2 (A), J4.2, R32.1, T4.3 (D)
/MPU_AD0: R13.2, U9.9
/MPU_INT: U8.18 (IO10), U9.12
/POW_LED: LED1.2 (A), R1.1
/SCL: R14.1, U8.17 (IO9), U9.23
/SDA: R12.1, U8.12 (IO8), U9.24
/STDBY_STAT: IC1.3, R4.2
/TP_PROG: IC1.6, Rprog1.1
/USB_D+: R23.2, U8.14 (USB_D+)
/USB_D-: R22.2, U8.13 (USB_D-)
GND: C1.2, C3.2, C4.2, C5.2, C6.2, C7.2, C9.2, C10.2, C11.2, C12.2, C13.2, C14.2, ESD1.2 (GND), IC1.5, J1.A1 (GND), J1.A12 (GND), J1.B1 (GND), J1.B12 (GND), J1.S1 (SHIELD), J3.2, LED1.1 (K), R13.1, R18.1, R19.1, R20.1, R21.1, R24.2, R25.2, R26.2, R28.2, R33.1, Rprog1.2, SW1.1 (A), SW1.4, SW2.1, SW3.2, T1.2 (S), T2.2 (S), T3.2 (S), T4.2 (S), U3.2 (GND), U8.1 (GND), U8.40 (GND), U8.41 (GND), U9.11, U9.18, U9.20, U9.25
LDO_EN: SW1.2 (B), U3.3 (EN)
unnamed: C15.2, R29.2
unnamed: C16.2, R30.2
unnamed: C17.2, R31.2
unnamed: C18.2, R32.2
unnamed: IC1.8, R33.2
unnamed: LED2.1 (K), R3.1
unnamed: LED3.1 (K), R4.1
unnamed: C12.1, U9.10
VBUS: C1.1, D1.1 (K), R2.1, U2.2 (S), U3.1 (IN)
