CopperPilot/CopperPilotDronePCB/(commit log)

2026-10-20 feat(manufacturing): add LionCircuits 8-column BOM export (.csv/.xlsx)
    Extend the manufacturing export pipeline to generate LionCircuits-compatible 8-column BOMs alongside existing JLCPCB artifacts without altering any KiCad schematic or PCB source files.
    - Add LIONCIRCUITS_BOM_MAP translating all 29 unique component groups to Western distributor (Element14/Mouser/DigiKey) MPNs, IPC package names, descriptions, and assembly instructions
    - Add pure-Python OpenXML (.xlsx) fallback writer in write_lioncircuits_xlsx() so .xlsx BOM workbooks are produced even when openpyxl is unavailable
    - Export both CopperPilotDrone-bom-lioncircuits.[csv|xlsx] and CopperPilotDrone-bom-original.[csv|xlsx] to pc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
2026-10-20 fix(manufacturing): resolve D2-D5 SOD-323 MPN and sanitize SW2-SW3/IC1/U9 LionCircuits BOM notes
    - Replace SOD-123 1N5819HW-7-F on D2-D5 with true SOD-323F PMEG4010EJ,115 (and SOD-323 alternates B5819WS-TP, PMEG4010CEJ,115, XBS104S13R-G, 1N5819WS) matching the D_SOD-323 land pattern
    - Remove oversized 6x3.8mm (434121025816) and 7.45mm tall (EVQ-P0E07K) tactile switch alternates from SW2-SW3 assembly instructions
    - Reinforce DO-NOT-SOLDER / consignment / DNP instructions for catalog-pass MPNs MAX1811ESA+ (IC1) and ICM-20789 (U9)
    - Export uncompensated native IPC-7351 CopperPilotDrone-cpl-lioncircuits.csv during --cpl export
2026-10-20 feat(dfm): apply LionCircuits Standard Tier DFM upgrades and dual Turnkey/DNP exports
    - Upsize all 83 signal vias and 12 U8 pad 41 thermal holes from 0.30/0.60 mm to 0.35/0.65 mm to meet LionCircuits Standard Tier (>= 0.35 mm drill) without surcharges
    - Remove F.Paste from U9 (MPU-6050 QFN-24) center pad 25 per TDK InvenSense specification (Rev 3.4 Section 11.2) to prevent reflow solder float
    - Synchronize schematic and PCB MPN properties with verified Western distributor (Element14 / Mouser / DigiKey) part numbers across all 28 Tier-1 BOM lines
    - Export F.Paste and B.Paste stencil Gerbers, Safe Turnkey DNP BOM/CPL variants (excluding IC1 and U9 portal placeholders), LIONCIRCUITS_ORDER_SPEC.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
2026-10-20 docs(review): add cropped schematic and PCB change screenshots for LionCircuits PR
    Add high-resolution Before/After/Diff PCB screenshots (U9 Pad 25 F.Paste removal, 0.35 mm via drill upsizing on F.Cu and B.Cu) and annotated schematic block crops showing MPN synchronization across all functional blocks.
2026-10-27 fix(dfm): resolve via-to-pad, slot width, annular ring, and acute corner DFM issues
    Reposition 7 vias away from adjacent SMD pads, widen J1 USB-C shield slots from 0.60mm to 0.85mm, upgrade 0.35mm drill vias from 0.65mm to 0.68mm pad diameter (0.165mm annular ring), chamfer acute bends on +3V3 and /D+, and increase +3V3 trace-to-mask clearance near U3.
2026-10-27 fix(dfm): resolve silkscreen-to-pad, silkscreen-to-hole, line width, and orphan NPTH DFM issues
    Retract footprint silkscreen lines on SW1, D1-D5, J1, J3, T1-T4, LED1-LED3, and 0603 passives away from pads and vias, relocate 12 pure GND stitching vias out from under silkscreen graphics, upgrade silkscreen stroke width to 0.16mm, and remove 32 orphan mid-air NPTH holes from the antenna cutout.
2026-10-27 fix(dfm): clear final T1-T4 silk-to-pad, U2/R29 silk-to-hole, and J1 slot warnings
    Shift T1-T4 SOT-23 Pin-1 silkscreen tick to 0.25mm pad clearance, move +BATT via and U2/R29 silkscreen for >=0.22mm hole clearance, and tune J1 USB-C S1 oval slot dimensions to 0.65x1.7mm and 0.65x1.35mm.
2026-10-27 fix(bom): resolve LionCircuits procurement MPNs for D2-D5 (1N5819WS) and U3 (AP7365-33WG-7)
    Update LIONCIRCUITS_BOM_MAP to use in-stock 1N5819WS (SOD-323) and pin-compatible Diodes Inc AP7365-33WG-7 (3.3V 600mA SOT-23-5, Pin 1=IN, 2=GND, 3=EN, 4=NC, 5=OUT) so all 30 BOM lines achieve 100% availability on LionCircuits.
2026-10-27 feat(sch): redesign IC1 to MCP73833T-AMI/UN and U9 to MPU-6500
    - Replace IC1 with Microchip MCP73833T-AMI/UN in MSOP-10 (4.2V 1S LiPo charger with dual STAT1/STAT2 status outputs and 10k THERM grounding resistor R33)
    - Replace U9 with native 3.3V TDK InvenSense MPU-6500 in 3x3mm QFN-24 (I2C mode with ~CS pulled high, RESV_GND grounded, and VDDIO/VDD decoupling)
    - Register local KiCad symbol and footprint libraries for fully portable builds
    - Verify 0 ERC errors or warnings via kicad-cli sch erc
2026-10-27 fix(sch): complete GND symbol #PWR913 and pin ties on IC1/U9 for zero ERC
    Verify 0 ERC violations across all severities via kicad-cli sch erc.
2026-10-27 fix(pcb): route MCP73833 charger, MPU-6500 IMU, and R33 pull-down with 0 DRC violations
    Complete surgical layout redesign on PCB:
    - Update IC1 footprint to MSOP-10 (Microchip MCP73833T-AMI/UN) and route +5V, +BATT, GND, /TP_PROG, /STDBY_STAT, and /CHRG_STAT
    - Update U9 footprint to QFN-24 3x3mm (TDK InvenSense MPU-6500) and route I2C (SDA, SCL), INT, AD0, REGOUT, and power/GND
    - Add R33 10k 0603 pull-down resistor on B.Cu for MCP73833 THERM pin
    - Refill copper zones and verify with KiCad 10 DRC (0 violations, 0 unconnected items) and ERC (0 violations)
2026-10-28 fix(pcb): resolve all post-redesign JLCDFM clearances on IC1, U9, R33, C5, and R26
    Clear via-to-pad on C13 (+3V3 via moved to y=87.65 with 0.68/0.35mm pad/drill), size IC1 MSOP-10 pads to 0.28x1.45mm for 0.22mm solder mask dam, set C5 Pad 2 and IC1 Pad 5 solid GND zone connections, stitch R26 GND zone at (143.15, 70.5675), and retract silkscreen on IC1, U9, R33, R26, and T2 for 0 JLCDFM dangers and 0 KiCad DRC violations.
2026-10-28 feat(fab): regenerate BOM/CPL for MCP73833T-AMI/UN and MPU-6500 with 32/32 tests passing
    Group C6/C12/C13 0.1uF MLCCs, route +3V3 around U9 on F.Cu with zero extra vias (6 +3V3 vias total) and chamfered bends, and verify 0 DRC violations, 0 ERC violations, and 32/32 automated PyTest checks.
2026-10-28 docs(review): add clean-room JLCDFM and LionCircuits turnkey PCBA verification report
    Document clean-room manufacturing verification for LionCircuits turnkey PCBA on branch fix/20261028-lioncircuits-prep:
    - Complete pre-run sanitization of build caches, JLC cart, and LionCircuits portal/cart.
    - 0 DFM danger violations across 28 automated fabrication checks on JLCPCB.
    - 100% turnkey component availability (30 of 30 BOM line items) on LionCircuits.
    - Order package saved to LionCircuits shopping cart for 5 units (ENIG finish, automatic SMT assembly, PID 251808).
    - 32/32 automated PCB PyTest test suite passing with 0 DRC violations.
2026-10-28 fix(pcb,sch): resolve Issue #3 +BATT trunk, +5V charger decoupling, T4 flyback loop, and U8 keepout
    - Rewire #PWR028 from VBUS to +5V so C6 (100 nF) and C7 (10 uF) decouple the +5V charger input rail (D1.2 / IC1 VDD) while VBUS retains C1 (10 uF)
    - Widen J3.1 +BATT F.Cu exit to dual 1.27 mm paths and add 3x 0.8/0.4 mm stitching vias tying directly into the 1.524 mm B.Cu +BATT trunk
    - Reposition D5 adjacent to T4 drain (2.15 mm direct path, down from 12.32 mm) and place C18/R32 with zero courtyard overlaps
    - Add copperpour keepout behind U8 Pads 1 and 40 with dedicated inward GND ties and stitching vias
    - Verified 0 ERC errors, 0 DRC errors, 0 unconnected nets, and 32/32 PCB pytest checks pas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
2026-10-28 docs(readme): synchronize architecture and BOM with 69-part MCP73833/MPU-6500 design
    - Update root README.md and pcb/README.md block diagrams, component specs, and 69-part BOM table (MCP73833T-AMI/UN charger + R33 THERM bias, MPU-6500 IMU + C13 REGOUT filter, R29-R32 snubber damping resistors, C6/C7 +5V charger decoupling)
2026-10-28 fix(dfm): resolve all JLCDFM silkscreen-to-hole dangers and complete LCSC BOM mapping
    - Relocate VBUS B.Cu transition via to (122.0483, 72.00) to clear B.SilkS graphics by >1.5 mm
    - Remove internal F.SilkS tick marks under C18 body and relocate third J3 +BATT stitching via to (146.3113, 81.20)
    - Populate LCSC part numbers for IC1 (C47182) and U9 (C112979) in export_manufacturing.py so JLCPCB and LionCircuits preflights both pass with 0 errors and 0 warnings
    - Verified 0 JLCDFM Dangers across all 28 checks and 0 KiCad DRC errors
